greyeey/b-parasite/kicad/parasite.pdf

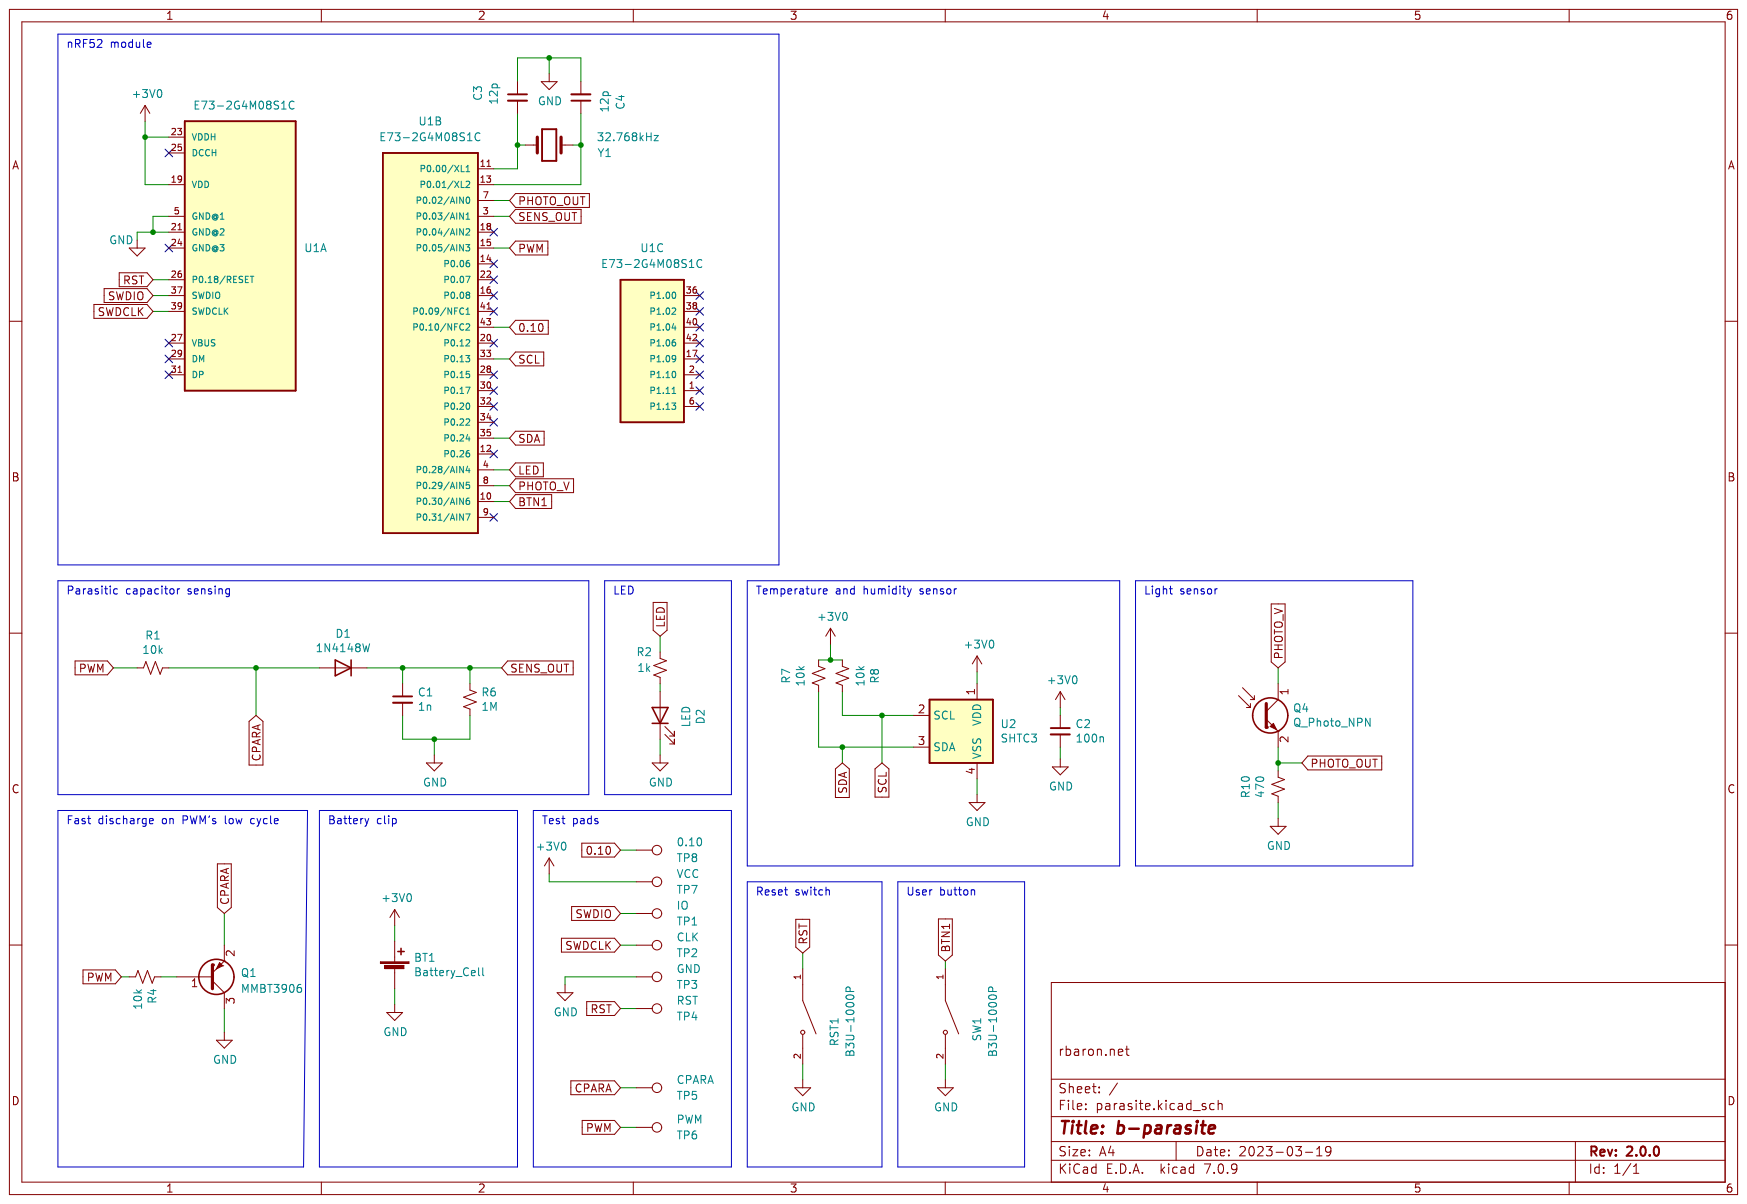
[picture p1: page 1]
