greyeey/b-parasite/kicad/parasite.kicad_pcb

## KiCad design kicad/parasite.kicad_pcb (2023-12-15)

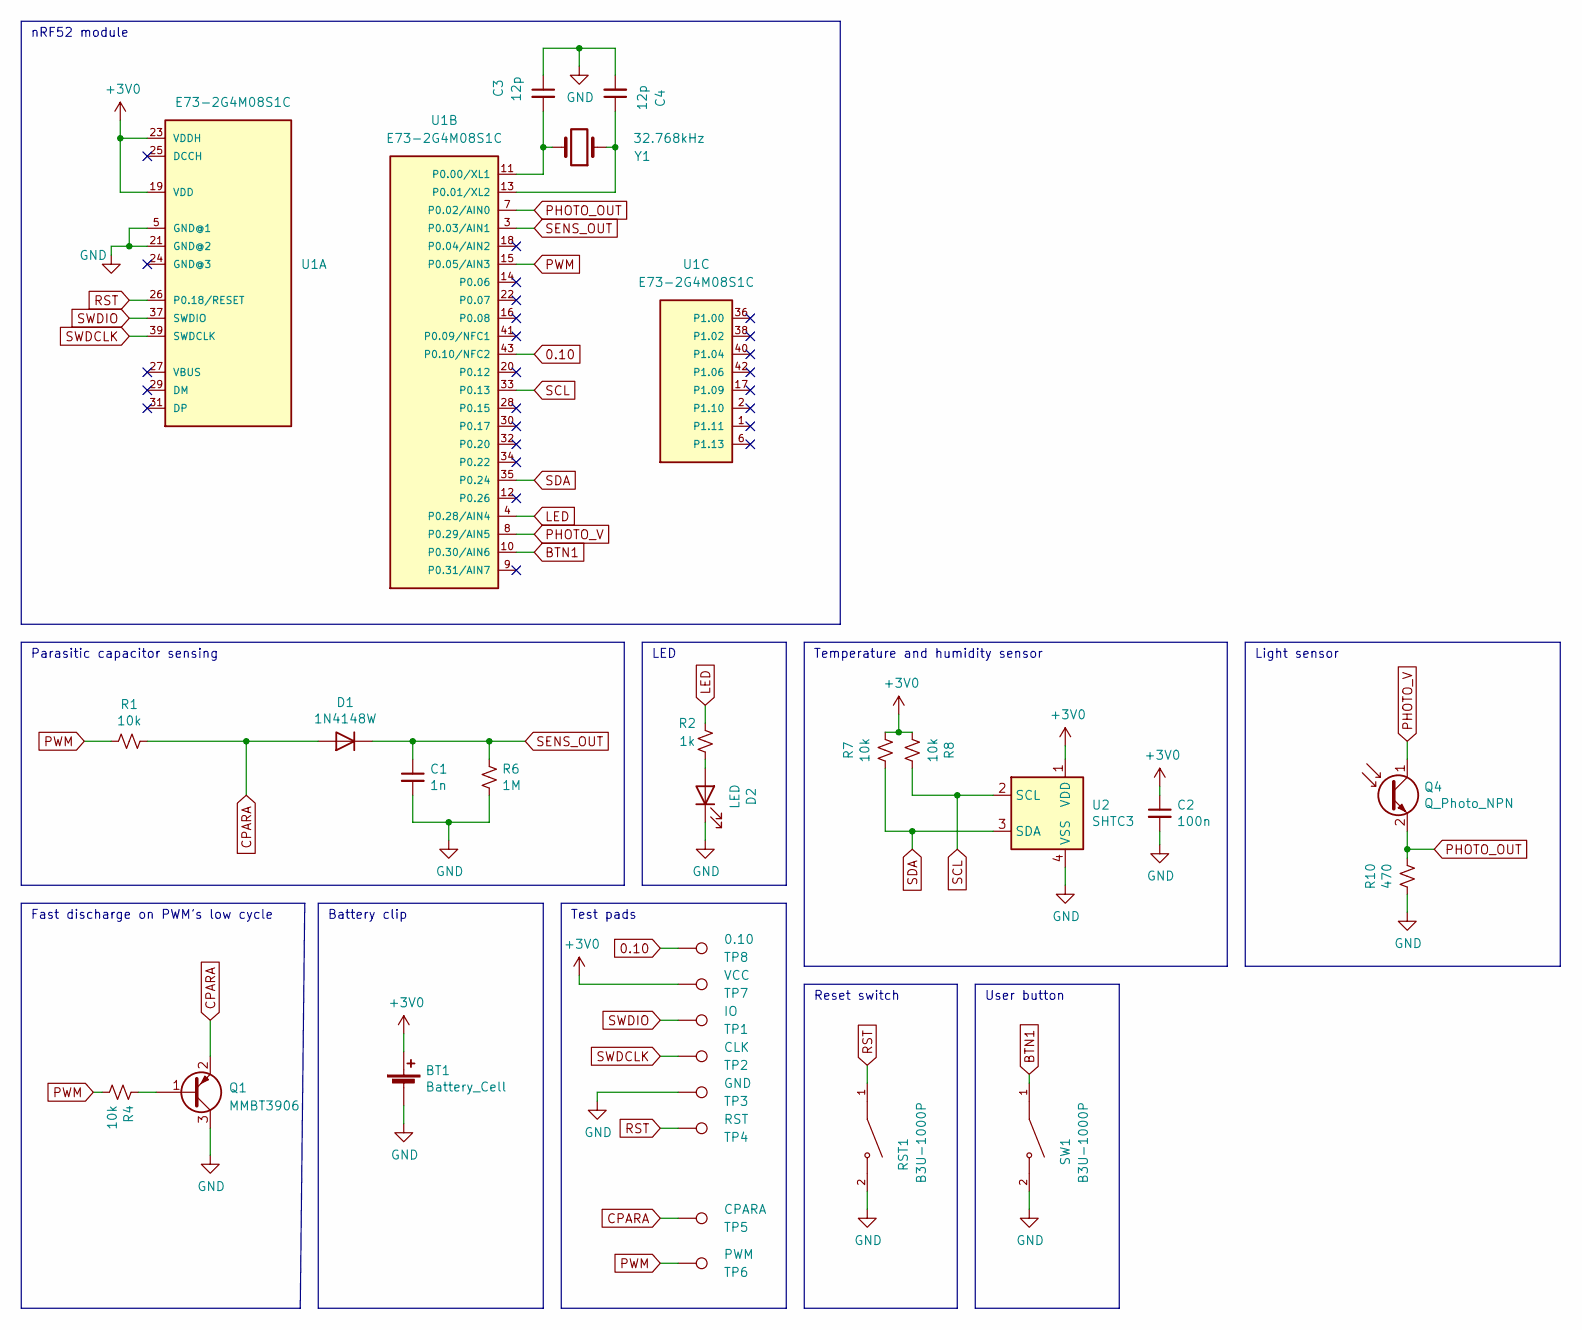
[picture p2: schematic parasite.kicad_sch, b-parasite]

Parts:
BT1: Battery_Cell; BatteryHolder_Keystone_3002_1x2032
C1: 1n; C_0805_2012Metric; LCSC C1523
C2: 100n; C_0805_2012Metric; LCSC C1525
C3, C4: 12p; C_0805_2012Metric; LCSC C1547
D1: 1N4148W; D_SOD-123; LCSC C9808
D2: LED; LED_0603_1608Metric; LCSC C2286
Q1: MMBT3906; SOT-23; LCSC C2910191
Q4: Q_Photo_NPN; TR8; LCSC C146233
R1, R4, R7, R8: 10k; R_0805_2012Metric; LCSC C25744
R2: 1k; R_0805_2012Metric; LCSC C11702
R6: 1M; R_0805_2012Metric; LCSC C26083
R10: 470; R_0805_2012Metric; LCSC C25117
RST1: B3U-1000P; SW_B3U-1000P; LCSC C231329
SW1: B3U-1000P; SW_B3U-1000P; LCSC C231329
TP1: IO; TestPoint_Pad_D1.0mm
TP2: CLK; TestPoint_Pad_D1.0mm
TP3: GND; TestPoint_Pad_D1.0mm
TP4: RST; TestPoint_Pad_D1.0mm
TP5: CPARA; TestPoint_Pad_D1.0mm
TP6: PWM; TestPoint_Pad_D1.0mm
TP7: VCC; TestPoint_Pad_D1.0mm
TP8: 0.10; TestPoint_Pad_D1.0mm
U1: E73-2G4M08S1C
U2: SHTC3; Sensirion_DFN-4-1EP_2x2mm_P1mm_EP0.7x1.6mm; LCSC C194656
Y1: 32.768kHz; Crystal_SMD_3215-2Pin_3.2x1.5mm; LCSC C32346

Connections:
0.10: TP8.1, U1.43 (P0.10/NFC2)
+3V0: BT1.1 (+), C2.1, R7.2, R8.1, TP7.1, U1.19 (VDD), U1.23 (VDDH), U2.1 (VDD)
BTN1: SW1.1, U1.10 (P0.30/AIN6)
CPARA: D1.2 (A), Q1.2 (E), R1.2, TP5.1
GND: BT1.2 (-), C1.2, C2.2, C3.1, C4.2, D2.1 (K), Q1.3 (C), R6.2, R10.1, RST1.2, SW1.2, TP3.1, U1.5 (GND@1), U1.21 (GND@2), U2.4 (VSS)
LED: R2.2, U1.4 (P0.28/AIN4)
unnamed: D2.2 (A), R2.1
unnamed: Q1.1 (B), R4.1
unnamed: C3.2, U1.11 (P0.00/XL1), Y1.2
unnamed: C4.1, U1.13 (P0.01/XL2), Y1.1
PHOTO_OUT: Q4.2 (E), R10.2, U1.7 (P0.02/AIN0)
PHOTO_V: Q4.1 (C), U1.8 (P0.29/AIN5)
PWM: R1.1, R4.2, TP6.1, U1.15 (P0.05/AIN3)
RST: RST1.1, TP4.1, U1.26 (P0.18/RESET)
SCL: R8.2, U1.33 (P0.13), U2.2 (SCL)
SDA: R7.1, U1.35 (P0.24), U2.3 (SDA)
SENS_OUT: C1.1, D1.1 (K), R6.1, U1.3 (P0.03/AIN1)
SWDCLK: TP2.1, U1.39 (SWDCLK)
SWDIO: TP1.1, U1.37 (SWDIO)

Notes on the sheet:
Fast discharge on PWM’s low cycle
Temperature and humidity sensor
LED
nRF52 module
Parasitic capacitor sensing
Test pads
Light sensor
Reset switch
User button
Battery clip

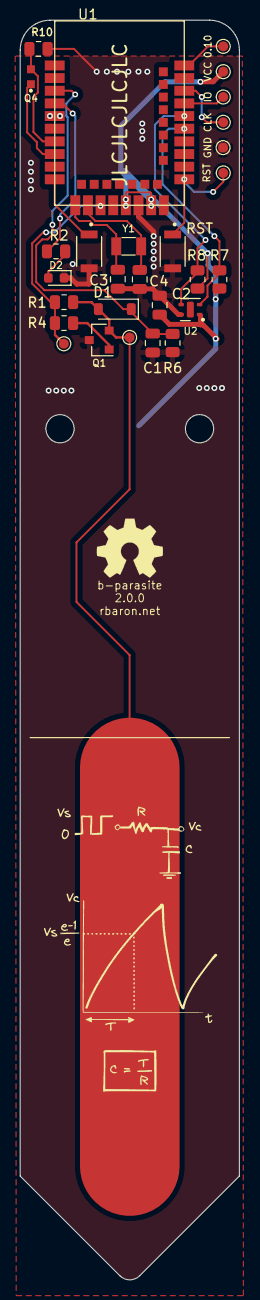
[picture p3: board parasite.kicad_pcb from above]

Board: 2 copper layers, 22.0 x 126.4 mm, 29 parts (1 on the bottom side), 19 nets.
