greyeey/b-parasite/(commit log)

2023-12-13 Diode Footprint changed
    Changed LL4148 to the 1N4148 variant, soldering preference.
    [parasite-B_Cu.gbl, parasite-B_Mask.gbs, parasite-B_Paste.gbp, parasite-B_Silkscreen.gbo, parasite-Edge_Cuts.gm1, parasite-F_Cu.gtl, parasite-F_Mask.gts, parasite-F_Paste.gtp]
2023-12-13 Update parasite.pdf
    Reflects new diode value
2023-12-13 Updated PCB and BOM
    Updated PCB and BOM to reflect new diode value
    [parasite.csv, parasite.kicad_pcb]
2023-12-13 Replaced Footprints
    Replaced all 0402 footprints with 0805, moved around the routing and parts to create space.
    [parasite-B_Cu.gbl, parasite-B_Mask.gbs, parasite-B_Paste.gbp, parasite-B_Silkscreen.gbo, parasite-Edge_Cuts.gm1, parasite-F_Cu.gtl, parasite-F_Mask.gts, parasite-F_Paste.gtp]
2023-12-15 R10 silkcreen
    R10 silkscreen was not correctly placed, also moved a trace around the ambient light sensor.
    [parasite-B_Cu.gbl, parasite-B_Mask.gbs, parasite-B_Paste.gbp, parasite-B_Silkscreen.gbo, parasite-Edge_Cuts.gm1, parasite-F_Cu.gtl, parasite-F_Mask.gts, parasite-F_Paste.gtp]
2023-12-15 Removed old production files
    And added new JLC bom
    [bparasiteJLCbom.xls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]
